Wooohaaa/anlogic-vision-system/docs/操作与部署.md

# 操作与部署

KEY1切换图像模式，KEY2开关双步进跟踪，KEY3开关白平衡，KEY4开关自动曝光与亮度增益。SW1控制颜色形状与运动，SW2控制ArUco，SW3控制手势，SW4控制数字识别。

板上采用联合Flash启动，电机默认关闭。电机使用独立12 V供电，并与开发板共信号地；控制接口为3.3 V。详细排针定义见技术文档。

工程构建与烧录使用仓库根目录tools/repository.py，安装路径通过config.local.json或环境变量配置。firmware目录保存FPGA配置、MCU应用和联合镜像，PACKAGE_MANIFEST.json提供SHA256校验。

## 2026-10-31 联合 Flash 记录

R6 areaopt4 FPGA bitstream 与 MCU target-os r18 payload 已组合为仓库 firmware/camera_system_flash.bit，并使用 FutureDynasty 官方命令行写入 PH1P35MDG324 外部 SPI Flash。器件 ID 0xC8，镜像 14,775,152 字节，厂商页写入与校验通过。串口和电机命令均未发送。

MCU 镜像保存在 Flash 中，启动程序负责校验并搬运到 MCU TCM；本次没有进行断电冷启动，因此不据此确认上电自动加载。当前 17 段视频套件未全部通过，已知问题见 [回归记录](VIDEO_SUITE_VALIDATION_20261029.md)。完整哈希和终端日志见 [部署记录](FPGA_MCU_FLASH_DEPLOYMENT_20261031.md)。

仓库 tools/repository.py program 是可选的本地构建流程入口；本次部署证据来自 FutureDynasty 命令行记录，不是该脚本的执行结果。
