Wooohaaa/anlogic-vision-system/THIRD_PARTY_NOTICES.md

# 第三方来源

- FPGA官方RTL、加密IP与工程来自Anlogic板卡工程，位于`contest2_hdmi_video/rtl/official`和`prj/user_source`；保留原文件及声明。
- `vendor/anlogic_sdk`来自当前工程实际使用的PH1P35 SDK，保留其各文件原许可声明。不同子组件可能采用不同许可证，不以本项目名义改写。
- TD、FD、GNU工具链可执行程序、USB驱动、调试服务均未打包，需要自行安装。
- 未给整个目录擅自添加MIT等统一授权；公开仓库前按原厂/第三方条款确认加密IP及SDK的再分发范围。确认之前可先使用私有仓库。
