Wooohaaa/anlogic-vision-system/docs/赛题二技术文档_实时图像处理与视觉交互系统.docx

# 基于安路FPGA的实时图像处理与视觉交互系统

摘要

本作品面向选题二实时图像处理任务[1]，基于安路PH1P35 FPGA构建720p视频处理平台。SC500摄像头经MIPI输入，图像由FPGA处理后写入DDR并通过HDMI输出；处理链包含自动白平衡、自动曝光、暗部增强、降噪和七种图像模式。FPGA完成颜色与形状、运动区域、手势及数字卡识别，板载MCU处理ArUco标记并调度双轴步进云台。系统采用四像素并行结构，按键切换图像模式和检测功能，画面叠加帧率、链路延迟及识别结果。

第一部分 作品概述

  1.1 功能与特性

系统以1280×720、60 fps视频为输入，通过HDMI输出。KEY1切换直通、灰度、Sobel、二值化、素描、浮雕与卡通化；KEY2控制步进跟踪，KEY3控制自动白平衡，KEY4控制自动曝光和增益。拨码开关分别启用颜色形状、运动、ArUco、手势与数字识别。识别框、类别和坐标叠加到画面，数码管显示增益index和开关状态。

  1.2 应用领域

系统用于实时图像处理教学与视觉交互演示。风格化模式显示像素处理结果；颜色目标联动云台演示视觉跟踪；数字卡和手势作为交互输入；ArUco标记叠加ID和方向轴，展示标记检测与图像可视化。

  1.3 主要技术特点

视频主链采用96位、每拍四像素的并行结构，像素、有效标志、行末和帧首信息同步传递。灰度、边缘和检测旁路共享数据流与行缓存，帧级统计和模板匹配复用运算单元。MCU处理ArUco候选解码和控制调度，FPGA负责固定吞吐的视频处理和步进脉冲时序。

  1.4 主要性能指标

资源数据采用最终整机布局布线结果，MCU数据来自最终应用构建记录；目标器件为PH1P35MDG324。联合镜像通过FutureDynasty官方命令行写入SPI Flash并完成逐页校验，指标见表1。

表1 主要性能指标

指标 | 数值
视频模式 | 1280×720，60 fps
彩色接口 | 96位，每拍4像素
Slice | 20,091 / 21,216
ERAM | 103 / 108
DSP | 30 / 40
建立裕量 SWNS | +0.132 ns
保持裕量 HWNS | +0.020 ns
总负裕量 | STNS / HTNS 均为0
联合镜像 | FPGA配置与MCU应用

  1.5 主要创新点

（1）构建采集、识别、显示与双轴执行闭环，实现视觉结果直接驱动机电联动。

（2）设计FPGA与片内MCU协同架构，兼顾并行视频吞吐、标记解码和控制调度。

（3）以四像素并行流水线、共享缓存和运算复用，在单芯片集成多模式处理与多类识别。

（4）将帧首时间戳与DDR帧槽绑定，在线观测对应视频帧的链路延迟及有效输入输出帧率。

  1.6 设计流程

以720p实时视频与视觉闭环为目标，先完成MIPI接收、DDR帧缓存和HDMI输出，统一四像素数据通路及帧级接口；随后集成画质增强、七种图像模式与多类识别，建立FPGA与MCU任务分工；再接入双轴步进云台，实现识别坐标到执行动作的联动。通过实机光照变化、目标切换及两轴动作逐项验证功能，结合布局布线报告优化资源及时序，最终生成并部署FPGA与MCU联合镜像。

第二部分 系统组成及功能说明

  1.1 整体介绍

系统由SC500摄像头、PH1P35开发板、HDMI显示设备和双轴步进云台组成。摄像头RAW10经MIPI输入FPGA；处理后的视频写入DDR并输出至HDMI。内容分析模块读取彩色视频，ArUco灰度快照送往MCU，识别结果返回FPGA叠加显示。红色目标坐标进入控制流程，MCU计算运动请求，FPGA输出STEP、DIR、SLP和RST信号。

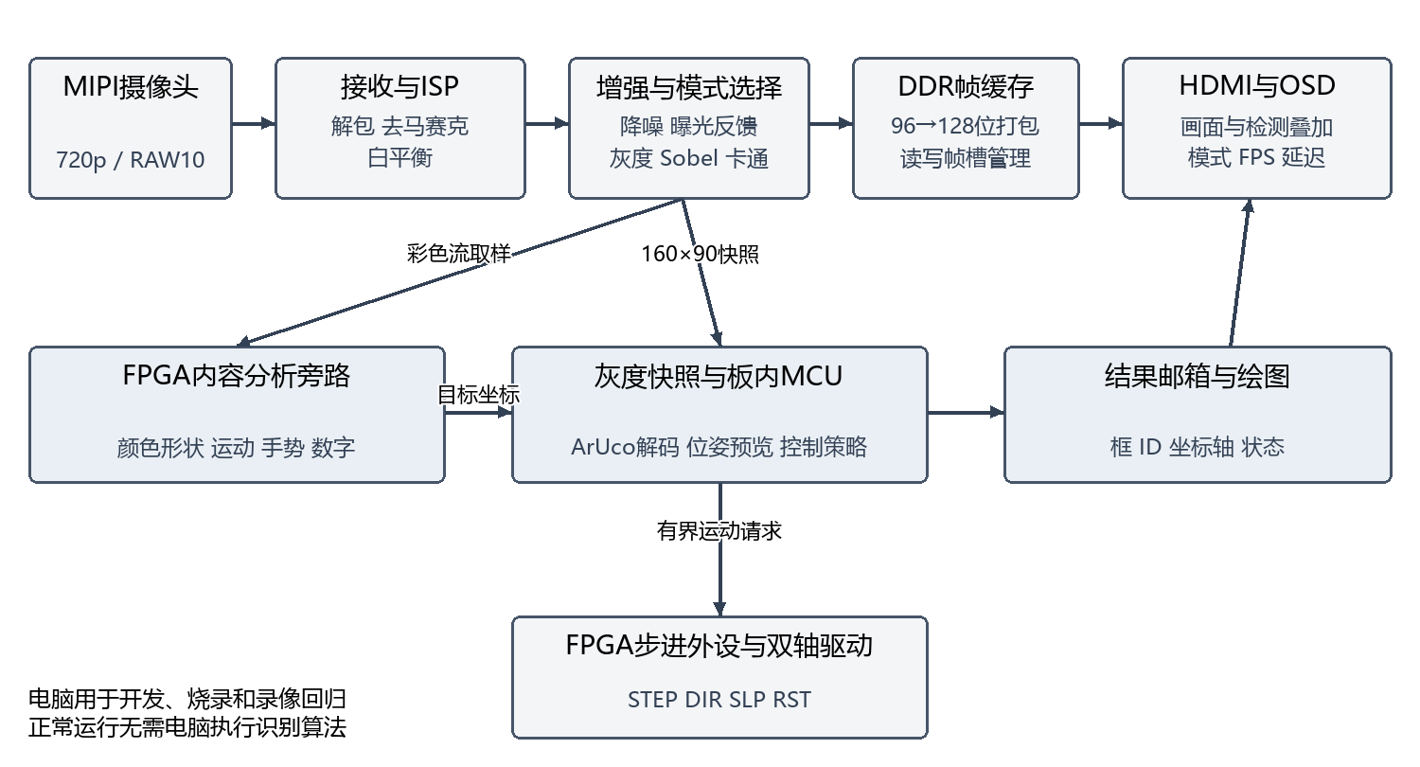
[picture p1: figure]

图1 系统数据通路与控制关系

  1.2 硬件系统介绍

2.2.1 硬件整体介绍

核心器件为PH1P35MDG324，使用板载DDR、SPI Flash、时钟、按键、拨码开关和数码管。SC500系列MIPI摄像头配置为1280×720模式；HDMI连接显示器或USB采集卡。系统时钟包括CSI恢复时钟、DDR时钟、HDMI像素时钟和50 MHz系统时钟，各时钟域通过帧缓存、邮箱、同步器和握手交换数据。

2.2.2 机械设计介绍

执行机构为双轴旋转云台，摄像头随云台转动。系统根据画面中心与红色目标中心的偏差，分别控制水平轴和俯仰轴。软件置零定义启动参考位置，累计步数用于相对运动控制；两轴方向经实物动作确认。

2.2.3 电路各模块介绍

摄像头连接开发板原有MIPI及I²C接口，HDMI使用板载输出，AL-LINK-FT用于工程下载。步进驱动采用DCC-100v3，J2扩展排针分别连接两路STEP、DIR、SLP和RST。GPIO控制电平为3.3 V，驱动由独立12 V电源供电，FPGA与驱动共信号地。

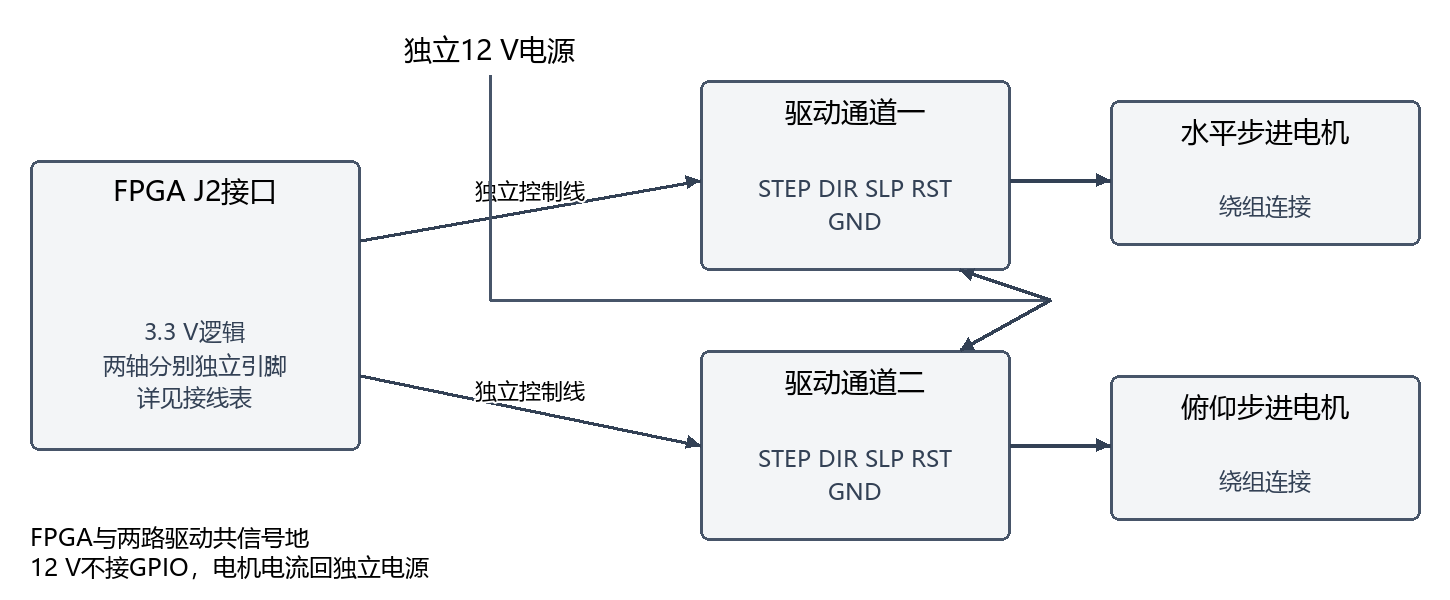
[picture p2: figure]

图2 步进驱动供电与控制信号

J2引脚与驱动信号对应关系见表2。

表2 J2引脚与驱动信号

开发板J2 | FPGA球脚 | 外部驱动连接
3 | E12 | 第一路 STEP
4 | E16 | 第一路 DIR
5 | E17 | 第一路 SLP
6 | F13 | 第二路 STEP
7 | F14 | 第二路 DIR
8 | F18 | 第二路 SLP
9 | G17 | 第一路 RST
10 | H17 | 第二路 RST
12 | GND | 第一路信号地
28 | GND | 第二路信号地

  1.3 软件系统介绍

2.3.1 软件整体介绍

软件由FPGA维护RTL、板载MCU程序和电脑端开发工具组成。RTL处理固定时序的视频数据，MCU运行视觉任务与控制调度；电脑端工具用于工程配置、构建、制作联合镜像和官方命令行下载。识别与控制任务在板上运行，电脑采集卡用于观察和录制HDMI画面。

2.3.2 软件各模块介绍

内容分析流程从彩色视频旁路取样，按帧发布检测结果；ArUco流程将灰度快照交给MCU解码，绘图数据返回FPGA后叠加到HDMI画面。

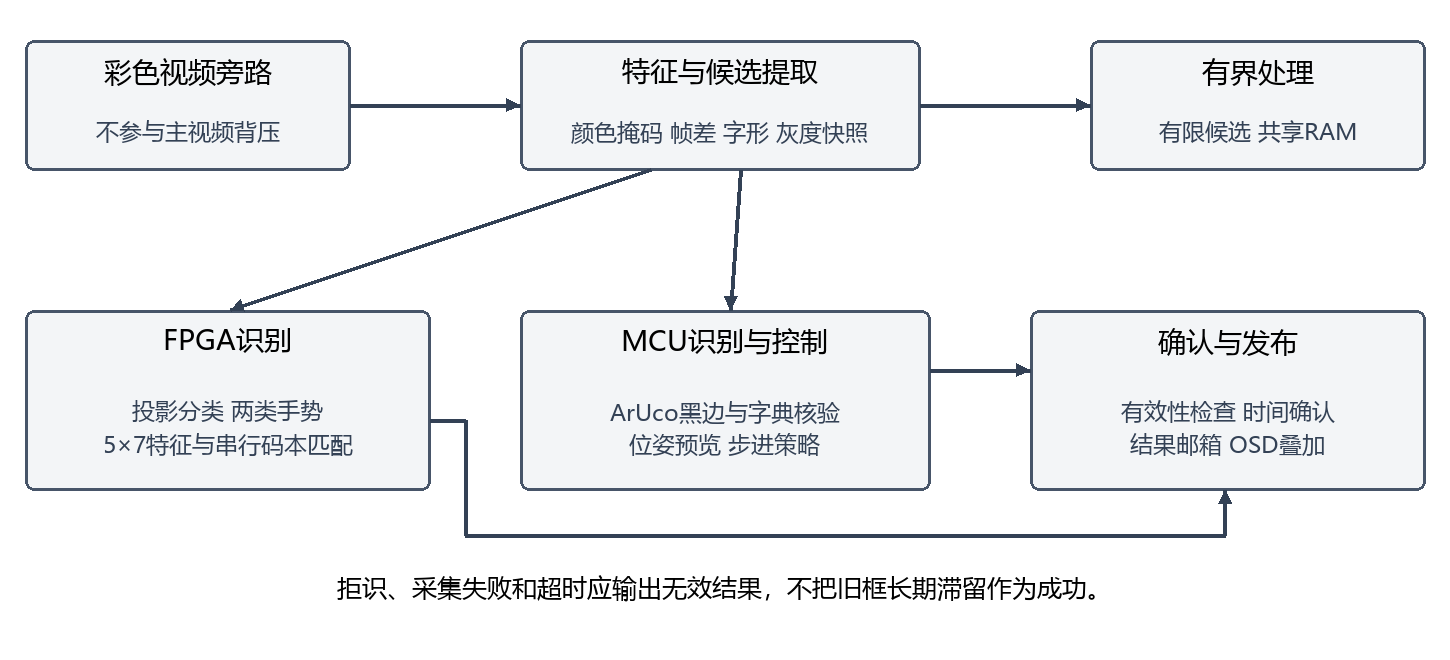
[picture p3: figure]

图3 内容分析与结果发布流程

视频采集与四像素流水线

SC500摄像头经MIPI接口输入RAW10数据，接收端完成数据解包、黑电平处理与Bayer去马赛克，将其整理为RGB888像素。视频计算采用96位总线，每个有效时钟同时传递四个连续像素。1280像素的一行对应320个数据组；主链在保持720p画面尺寸的同时，以并行计算降低单路处理节拍压力。

流水线将像素数据与tvalid、tuser、tlast一同传递，分别标记有效数据、帧起始和行结束。行缓存只在有效样本到达时更新，数据和边带信号则按约定的级数延迟；遇到有效信号空拍时，缓存地址和窗口位置仍与真实像素对应。模式选择经按键消抖和跨时钟域同步后在帧首锁存，使同一帧采用统一的处理方式。

处理后的视频经宽度适配进入DDR写通道，HDMI读通道按显示时序读取完整帧。DDR帧槽承担采集和显示之间的速率匹配，算法行缓存承担邻域访问，两者各司其职。颜色、形状、手势、数字与ArUco前端从风格化之前的彩色视频取样，识别所用的颜色和亮度不会随显示模式切换而改变。

七种图像模式的计算过程

直通模式保持RGB分量；灰度模式对每个像素计算红、绿、蓝分量的加权和，绿色权重为红、蓝的两倍，再右移两位完成归一化。该形式由加法和连线移位实现，不需要通用乘法器。二值化模式将组均值亮度与阈值比较，输出黑或白，适合直接观察明暗分布与分割边界。

Sobel模式先对同拍四个灰度值求均值，再在组灰度域建立3×3邻域。两个历史行缓存与当前行移位寄存器提供窗口，横向和纵向梯度分别按Sobel系数累加，取绝对值后求和并缩放为边缘强度。同一组的结果扩展到四个输出像素。因此，彩色主链仍是1280×720，邻域边缘计算则采用320组宽度的流式结构，显著减少行缓存和重复梯度运算。

素描模式将边缘强度反相，形成白底黑线；浮雕模式对窗口中的对角位置作方向差分，并加入中灰偏置，将正负变化转换为明暗层次。卡通模式在彩色支路进行亮度分段量化和受控饱和度增强，再以Sobel结果绘制轮廓。七种模式共用灰度、窗口和边缘结果，彩色支路按拍延迟对齐；模式选择位于统一输出端，用户算法模块保持固定八拍延迟。

自动白平衡与曝光控制

自动白平衡采用受约束的灰度世界统计。模块排除裁剪高光、过暗像素和高色度区域，从中等亮度、接近中性色的有效样本中累计红、绿、蓝分量；同时检查画面不同区域的样本支持和估计一致性，避免单一有色物体主导全帧增益。可信统计形成后，以绿色为参考计算红、蓝两路校正系数，限制系数范围，并通过连续估计确认和低通平滑抑制逐帧抖动。

增益估计与逐像素校正分开运行：统计在帧内持续累积，除法计算在帧级状态机中执行，候选增益只在后续帧首提交。这样，当前帧不会出现上半幅和下半幅采用不同增益的色彩分界。关闭白平衡时，控制逻辑按既定旁路配置运行，像素和边带仍保持统一时序。

自动曝光模块读取帧级亮度统计，综合主体亮度与高光情况决定曝光时间和模拟增益。偏暗时逐步增加曝光或增益，偏亮时反向调节；确认帧和稳定等待帧控制更新频率，避免每次亮度波动立即引发反向动作。统计结果通过稳定数据总线和翻转握手跨入控制时钟域，再由I²C配置流程写入SC500寄存器。KEY3、KEY4分别控制白平衡和曝光增益，数码管显示增益index，便于观察闭环调节过程。

降噪与暗部层次增强

图像后处理采用带色差门限的可分离有限窗口滤波。水平和垂直方向分别利用五个原始样本，按1、2、2、2、1的权重组合；只有邻域与中心的三个颜色分量差异均满足条件时，邻域才参与平滑。强边缘处保留中心值，平坦区则利用邻域平均降低噪点，避免简单全局平滑把目标轮廓一并抹去。暗部采用相应的色差门限，使低亮度区域获得更有针对性的处理。

后续色调与暗部提升由固定曲线和受控饱和度处理完成，曝光增益仍承担主要的亮度调节任务。有限窗口保存输入历史，不以已滤波输出递归累积；历史行数据打包到同步RAM中，以一拍读出、后续写回的方式形成垂直窗口。该模块保持每拍四像素的连续输入输出，以六级流水完成降噪和色调处理，逐像素路径不使用整帧平均、迭代除法或DSP乘法。

颜色分割与旋转形状判别

颜色检测在四像素组上统计RGB均值，以主色通道相对另外两路的差异、亮度和色度形成红、绿、蓝掩码。门限同时考虑暗部与颜色饱和情况，结合肤色排除和局部连续性，减少手持目标时手部与目标颜色相互干扰。每种颜色保留候选区域，随扫描更新面积、包围范围和投影极值，再按支持量与连续性选出用于发布的目标。

形状判别使用面积、宽高比、填充率与多个方向的投影跨度。除水平和垂直范围外，还统计斜向投影，比较归一化包围面积以选择更贴合目标朝向的几何尺度。长宽比反映细长程度，面积与包围面积的比例反映轮廓填充特征；这些信息共同支持圆形、方形、长条形与三角形判别。比例门限以交叉相乘比较，方向归一化使用已知的比例系数，避免在线开方和通用除法。

帧内只更新候选统计，帧末才启动形状计算、坐标平滑及类别确认，最终一次性发布中心、边框和类别。短时缺失、类别切换和重新捕获由独立的时间状态处理，使单帧颜色波动不会直接替换画面上的稳定结果。识别输出同时送往OSD和目标跟踪接口，显示与控制使用同一份帧级位置结果。

运动检测与相机运动抑制

运动模块在四像素组均值灰度域比较当前样本与上一帧同位置的参考值。参考存储通过同步双端口访问，当前地址读取旧值，地址和新灰度延后一拍写回，完成连续流中的读旧、比较和更新。整机配置对参考图作纵向间隔采样；显示视频仍逐拍完整传递。首帧先建立参考，背景重建请求锁存后在下一帧边界统一执行。

变化样本进一步累计到32×32网格。只有获得足够变化支持的网格参与运动范围统计，帧末汇总形成黄色区域框，并由MOV给出运动网格比例。云台动作信号送入网格策略：相机转动期间停止发布场景运动提示，停止动作后等待安静帧再恢复，从而把机械转动造成的整幅背景变化与被摄物运动区分开。

手势识别的帧级处理

手势支路将彩色样本转换为低分辨率手部观察帧，分别构造可靠种子和扩展候选掩码。连通域阶段按扫描顺序关联相邻区域，记录面积、包围范围、实际锚点和红色分量支持；随后在种子与扩展区域之间建立关联，用较宽的扩展轮廓保留手掌结构，用种子的颜色可信度约束背景混入。

候选先经过尺寸、比例、面积和颜色均值等低成本筛选，再进入选中区域的几何分析。区域掩码、掌心距离、轮廓、凸包与指尖相关特征由帧级状态机依次处理，结合投影和形态特征区分张掌与握拳。最终分类还要经过候选质量策略和时间投票，使输出类别、目标框和有效标志在同一观察结果上对应。

采集与分类通过缓冲区所有权握手衔接，分析过程持有的帧不会被下一帧输入覆盖。处理忙时采用明确的接收与丢弃规则，结果在完成后统一发布；连续无有效手部观察时释放历史结果。HDMI中H:O表示张掌，H:F表示握拳，H:-表示当前没有确认结果，诊断字符T反映检测内部状态。

数字卡定位与字形模板匹配

数字识别由定位和分类两级组成。定位器搜索浅色中性背景上的深色笔画，利用亮背景支持、局部行列连续性和字形聚合得到候选范围。确认后的包围框与后续归一化过程保持帧级对应，避免上一帧的框与当前帧笔画混用。卡片发生位置和尺寸变化时，定位状态先更新候选，再按确认策略切换有效区域。

字形以5×7共35个占用单元表示。归一化依据实际字宽划分五列、依据实际字高划分七行，累计各单元内的笔画支持后生成35位特征。尺寸相关的占用门槛使小字形仍能形成有效单元；闭环字形还检查中间行等结构支持，避免局部破碎的笔画仅靠少量相似单元形成高分匹配。

模板库为0～9每类保存64个尺寸、宽高和倾角变体，共640个有效模板。同步ROM逐项读出35位模板，与观察特征异或后计算汉明距离；串行扫描得到每类的最佳距离，再比较最佳类别和次佳类别。结果需同时满足匹配距离、类间差值和时间确认条件。画面左侧数字为识别类别，右侧两位十六进制数为次佳距离减最佳距离，反映类别分离程度；没有确认结果时显示横线。

ArUco识别与方向轴叠加

ArUco采用FPGA前端与片内MCU分工。FPGA将彩色视频取样为160×90灰度快照，通过寄存器和握手机制交给MCU；MCU把灰度压缩为每像素4位，两像素共用一个字节。该图仅服务标记分析，HDMI主图保持原视频尺寸。快照在处理期间保持稳定，MCU完成一轮任务后再释放采集资源。

检测端先建立16级灰度直方图并计算Otsu阈值，提取暗色连通区域与候选四边形，再检查边界支持和几何关系。对有效候选进行透视映射采样，依次验证外圈黑边和内部4×4编码，尝试旋转方向后与50个字典码字比较；局部阈值重试与角点细化用于适应成像变化，唯一字典匹配约束结果发布[2][3][4]。

识别后将四个角点映射回主画面坐标，并以120 mm标记边长和相机模型建立平面投影关系。位姿与方向轴计算在MCU中完成，输出ID、四边形角点及红、绿、蓝轴的二维端点[5][7][11]。FPGA接收完整结果后更新叠加参数，在HDMI上绘制标记轮廓、ID和方向轴，使解码计算与逐像素绘图保持分工。

双轴步进跟踪与硬件执行

跟踪以红色目标中心相对画面中心的水平、垂直偏差为输入。MCU根据使能状态、目标有效性和偏差计算两轴运动请求，并结合中心附近的低速控制、速度上限及加减速调节，使云台在接近目标时逐步减小动作。软件置零定义启动参考位置，累计步数保存相对位移，两轴方向按实物安装关系配置。

FPGA负责具有固定时序要求的STEP脉冲、DIR方向与SLP、RST控制，运动请求通过片内总线寄存器交接。控制状态、动作计数与目标位置分别保存，MCU服务ArUco任务期间，已提交的硬件脉冲仍按设定节拍执行。KEY2管理跟踪使能，视觉结果、运动调度和脉冲执行共同形成从目标位置到摄像头朝向调整的闭环。

信息叠加与板上交互

HDMI混合器在输出坐标域绘制Logo、文字、包围框、标记线段与方向轴。固定内容从同步ROM读取，几何图元依据当前扫描坐标判断是否命中；显示参数按完整检测结果更新，图元与背景视频通过流水级对齐。KEY1切换七种模式，SW1至SW4分别控制颜色形状运动、ArUco、手势与数字功能，便于逐项演示并观察组合运行。

MODE显示图像模式编号，D显示以毫秒计的板内帧链路延迟。延迟测量将输入帧首时间戳绑定到对应DDR帧槽，在该帧进入HDMI输出时取差，避免把不同帧的时间标记直接相减。IN统计每秒完整写入DDR的帧数，OUT统计有效输出的新帧数，重复帧与异常帧不作为有效新帧计入；两项共同反映采集与显示的有效视频吞吐。

2.3.3 资源优化设计

资源优化贯穿本工程的功能扩展过程。设计首先按像素、行、帧和候选任务区分运算频率：连续视频路径保留必要的并行度，帧级任务利用帧间计算时间执行串行状态机；存储按实际访问范围和数据存活期配置。优化对象包括运算器、RAM深度、记录组织、选择网络、常数算术和显示ROM，而不是只调整综合工具参数。

每项结构调整都同时检查数值范围、同步读延迟、同地址读写关系、帧边界和结果发布时间。模块面积用于定位收益来源，最终取舍依据整机布局与布线结果，兼顾Slice、ERAM、DSP和时序。这样可以将节省出的片上资源持续用于数字、手势、ArUco及云台功能的集成。

逐帧更新的AWB运算复用

早期实际启用的AWB链路使用两套50级流水除法器，分别处理红、蓝增益比值；实际增益只需按帧更新。改进后将两个比值任务送入同一个恢复余数迭代除法器，先计算绿色与红色累计值之比，再计算绿色与蓝色累计值之比。一次除法48步，两次共96个计算周期，加上启动和判定即可完成一帧的系数估计，不需要为每个有效像素提供新的商。

增益限幅、稳定性判断和平滑提交保留在帧级控制中，原有视频延迟缓存和数据节拍继续保持。720p配置中每个四像素组最多贡献一个统计样本，单帧最多230,400个样本，8位通道累加的最大值为58,752,000，26位即可覆盖。依此收缩累加器、比较器和状态选择网络，同时保持帧内增益一致。

按实际访问深度重构行缓存与参考帧

AWB原始延迟RAM固定为96位×2048字，720p四像素结构每行实际仅访问320字。工程改为96位×512字的双端口同步存储，逻辑容量由196,608位降为49,152位，减少75%，同时保持原有端口契约和一拍同步读行为。容量压缩来自去除未被访问的地址空间，视频数据宽度和处理精度保持不变。

运动参考图在组灰度域保存8位亮度，整机配置每四行取样一次；参考深度按有效组数和采样行数精确计算，避免宏单元固定深度产生额外占用。图像后处理将四条历史行组织成一个宽字，在读出后移位并写回，减少独立RAM存储体及外围地址控制。主显示帧继续存入DDR，片内ERAM集中服务行邻域和识别状态。

候选描述符与手势工作区复用

颜色与形状检测需要长期保存候选的面积、包围范围和多方向投影。早期使用宽寄存器数组，动态选择候选时会形成较大的多路选择与更新网络。工程将适合串行访问的描述符搬入同步ERAM，帧内按地址读取候选、计算更新结果并写回；保留必要的当前行状态与获胜候选缓存，使连续像素输入不必等待整个候选库访问。

手势链路按处理阶段复用同一工作区：区域扩展队列、掌心距离和轮廓几何等任务在各自拥有存储期间访问地址，前一任务最后一次读取完成后才交给下一任务。公共工作RAM采用同步读和显式读写使能，算法负责初始化所需内容，避免整块存储的异步清零被映射为大量触发器。

连通域关联与描述符构建直接利用已有的组件记录，不再复制一份整帧描述符RAM。对不同阶段互斥使用的数据采用打包存储和端口复用；例如二值路径的原始通道缓存与后续队列共享存储生命期，并以相邻字及双端口组织维持读取节拍。因此，公共存储按各阶段的最大工作集配置，无需为生命周期互斥的数组分别保留完整容量。

三色分类与坐标平滑的分时计算

红、绿、蓝三路目标在帧末的分类任务具有相同的数据形式。工程保留三色候选状态和每色两个候选槽，将面积归一化、长宽比例判断、类别比较等运算送入共享数据通路，依次选通颜色和投影方向，完成后再统一发布三路结果。主像素链路继续每拍接收四像素，共享仅作用于帧级结果计算。

目标中心和边框的坐标平滑也使用共享加法、移位及限幅逻辑，状态机遍历需要更新的坐标字段，结果暂存在工作寄存器中。原本每种颜色、每个坐标都复制的组合运算由同一套计算资源承担，减少重复进位链与宽选择网络。在相同功能组合的整机阶段，字库、坐标平滑与面积归一化共享合并后，Slice由20,491降至19,516，减少975，ERAM和DSP数量保持不变。

定点位宽和常数算术优化

坐标、面积、累加和乘积按各自的合法上界确定位宽。加法和差分在运算前显式扩展，乘法保留所需的全宽结果，比较前统一符号与尺度，避免隐式32位整数把小坐标运算展开为宽数据通路。常数倍数以移位加减实现，比例条件通过交叉乘积判断，减少通用乘除运算。

手势几何中的低频乘积采用共享移位累加单元。紧凑实现将乘积寄存器同时用作部分和与移位状态，只额外保存必要宽度的被乘数，在指定迭代次数后给出完整结果，避免并列保存多个超宽中间量。像素级高频计算与帧级低频计算分别选择并行和串行结构，使DSP资源服务真正需要固定吞吐的路径。

图像曲线与显示内容的ROM化

固定色调曲线由组合分支查表转为同步ROM，保持每个输入码值的映射。对小数系数、饱和判断和通道差值的计算进行范围分析后，将可以共享的项提取出来，减少重复宽RGB选择器。一个图像处理优化阶段的整机Slice由20,916降至20,087，减少829；ERAM由69增至75，DSP保持13，体现了利用片上存储替代组合查表逻辑的效果。

Logo使用无损的分段紧凑表示。元数据先给出当前行段的有效范围与索引起点，再读取颜色索引并查询调色板；透明区域由有效性标志直接处理，不必为全部背景地址存储完整RGB值。颜色索引主体采用9位存储，并对需要扩展的索引进行补位，既保留原有彩色点，又降低索引存储宽度。元数据、索引、调色板形成三级同步读取，混合器提前发出地址以维持外部像素时序。

文字字库只保留界面实际使用的英文、数字、标点及“安”“路”字形，整理为1024×16同步ROM。字符码和行号转换为紧凑地址后一次读出字形行；原有字形点阵保持一致。字库、Logo和色调曲线分别按内容特征组织，不再统一依赖大规模组合case展开。

数字模板与特征更新结构优化

数字模板的有效数据为640×35位，按1024×35位同步ROM组织，以统一地址顺序扫描模板。分类器复用一套异或、位计数和最小距离比较逻辑，避免为640个模板同时复制比较树。观察帧只需保存35位占用特征及少量稳定确认状态，模板变体规模不会成比例增加帧级寄存器。

5×7特征按行组织占用状态与写使能，坐标归一化采用明确位宽的边界运算和常数移位加法，缩小可变位索引及动态多路选择结构。特征累积、帧末成图、模板读取和类别发布分属确定阶段，模板同步读所需的等待拍由分类状态机吸收，视频主链不增加反压。

MCU缓存压缩与任务协同

160×90快照包含14,400个灰度像素，8位缓存需14,400字节，4位打包后为7,200字节，图像缓存容量减半。16级直方图与这一表示保持一致，候选检测按阶段复用工作区，解码、角点细化与方向轴计算在同一帧数据上依次推进。软件采用面向体积的编译选项，并保留栈使用记录，使图像缓存、静态数据和函数栈共同纳入片内TCM预算。

最终MCU映像的代码为28,876字节，已初始化数据240字节，静态零初始化区16,572字节；计入2,048字节栈预留后的总预算为47,736字节，满足49,152字节的TCM空间配置。FPGA提供灰度采集、绘图和步进时序，MCU集中处理候选解码及控制调度，避免将复杂的标记几何运算全部复制为FPGA并行硬件。

整机资源收益与最终实现

表3列出开发过程中几项具有整机数据支撑的结构优化。前三项分别对应当时功能组合下的前后对照；最后一项展示最终集成结构与其直接基线的资源分配。不同阶段的功能组合和实现快照不同，各项差值单独计算，不相加作为累计节省量。

表3 代表性阶段资源优化对照

优化结构 | Slice 前→后 | 变化 | ERAM 前→后 | DSP 前→后
图像曲线等查表逻辑同步ROM化 | 20,916→20,087 | −829 | 69→75 | 13→13
字库与三色分类、坐标平滑共享 | 20,491→19,516 | −975 | 97→97 | 25→25
候选存储及算术结构重组 | 19,974→19,708 | −266 | 97→106 | 35→31
最终集成与存储再压缩 | 19,997→20,091 | +94 | 108→103 | 31→30

最终集成在直接基线上增加94个Slice，同时减少5块ERAM和1个DSP，形成20,091 Slice、103 ERAM和30 DSP的整机配置。最终布局布线报告给出的建立、保持裕量分别为+0.132 ns与+0.020 ns，总负裕量均为0。资源优化因此同时服务于功能集成、片上存储分配和时序实现，最终指标统一采用表1所列数据。

2.3.4 联合镜像与部署

联合Flash镜像包含FPGA配置、MCU引导程序和应用载荷。构建入口统一组织RTL、约束、ROM初始化文件与MCU程序，发布时保存最终固件及SHA256校验摘要。联合镜像已通过FutureDynasty官方命令行写入SPI Flash并完成逐页校验，源码、工程配置、最终资源时序报告与技术文档配套归档。

第三部分 完成情况及性能参数

  3.1 整体介绍

本作品完成SC500摄像头MIPI采集、FPGA四像素并行处理、DDR帧缓存、HDMI输出与双轴步进执行的整机集成。在1280×720、60 fps平台上实现七种图像模式、自动画质调节和多类识别，片内MCU完成ArUco解码与云台调度，实机成果见图4至图7。

  3.2 工程成果

3.2.1 机械成果

完成摄像头、双轴步进云台、开发板与驱动器的一体化装配，建立摄像头视轴与水平、俯仰两轴的运动关系。控制流程以目标中心相对画面中心的偏差生成两轴运动请求，结合方向控制与累计步数实现相对位置调节。图4、图5展示整机结构及安装关系，识别坐标与执行机构在同一系统内联动，构成主动视觉跟踪平台。

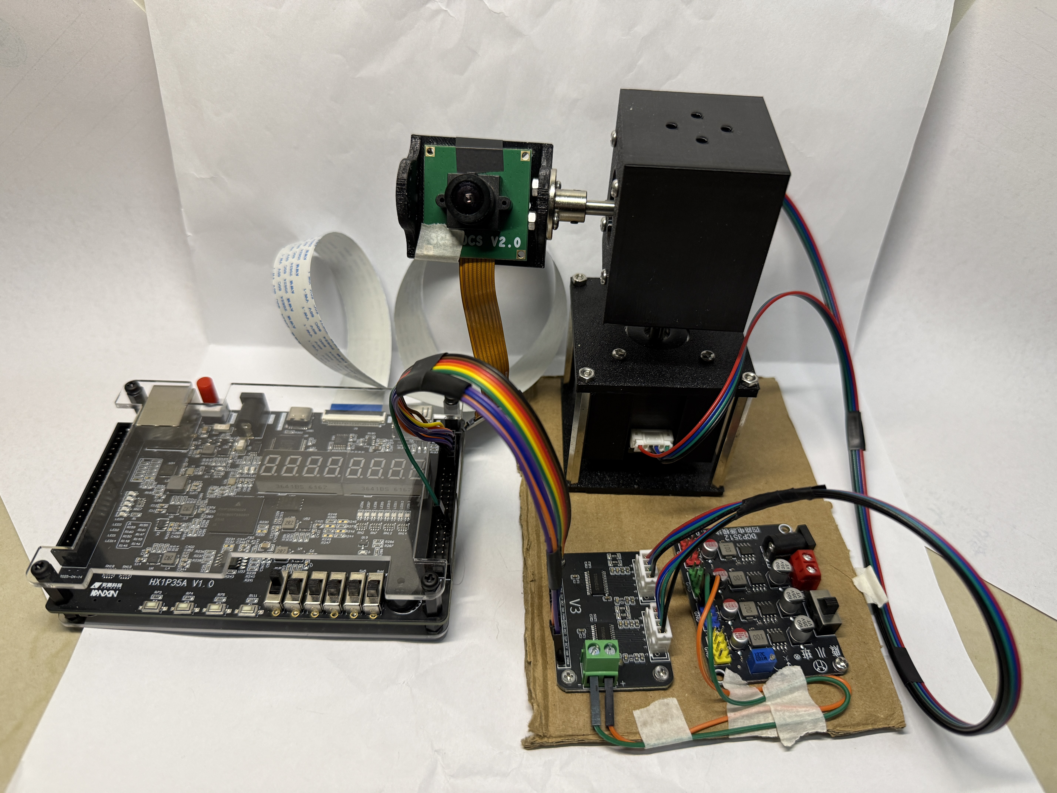
[picture p4: figure]
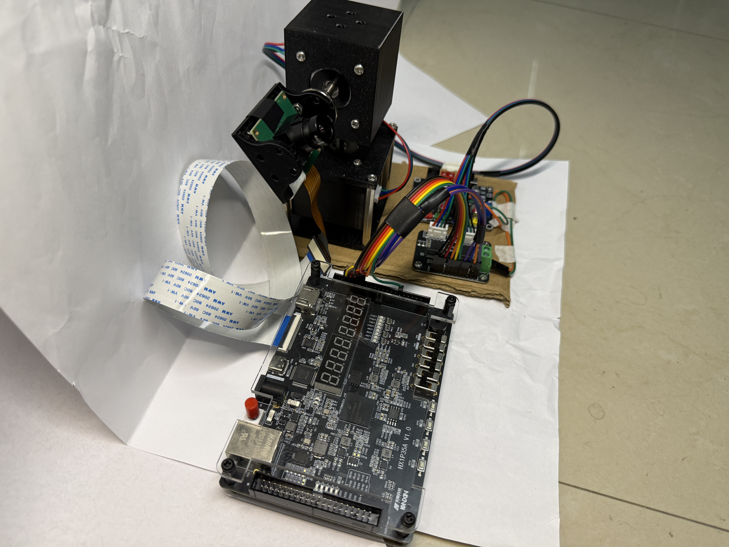
[picture p5: figure]

图4 整机正面 | 图5 整机斜侧面

3.2.2 电路成果

电路成果覆盖MIPI采集、DDR帧缓存、HDMI输出和双轴步进控制。J2引出两轴STEP、DIR、SLP、RST及信号地，驱动器采用独立12 V电源和3.3 V逻辑控制；图2和表2给出供电结构与引脚分配，可与实物接线逐项对应。

3.2.3 软件成果

软件成果包括FPGA RTL、片内MCU应用、TD工程、约束、ROM资源及构建部署工具。图6、图7给出七种图像模式与多类识别的实机结果；FPGA与MCU联合镜像已完成SPI Flash写入及逐页校验。

图6 七种图像处理模式

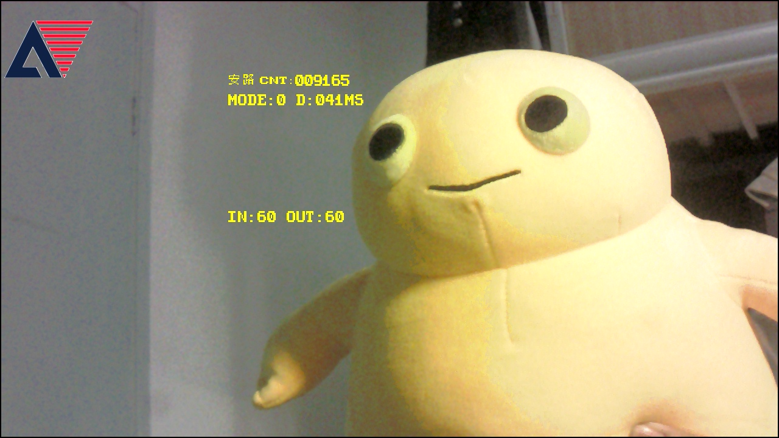
[picture p6: figure]
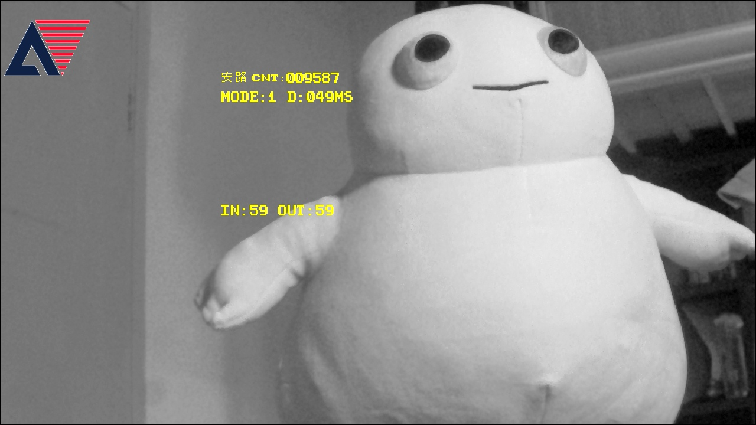
[picture p7: figure]

直通 MODE 0 | 灰度 MODE 1

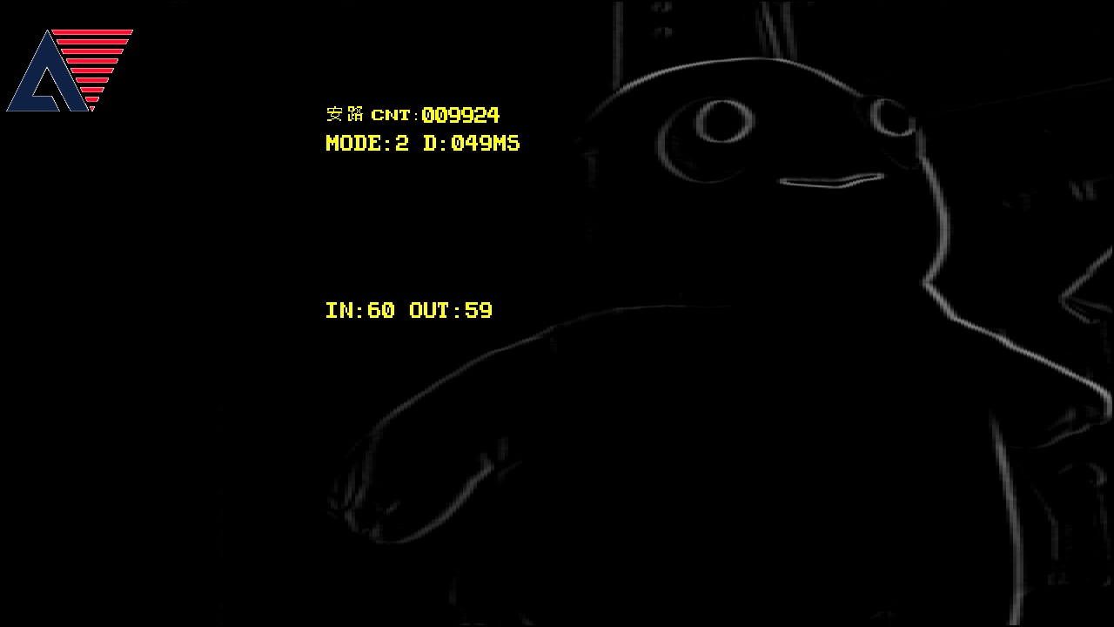
[picture p8: figure]
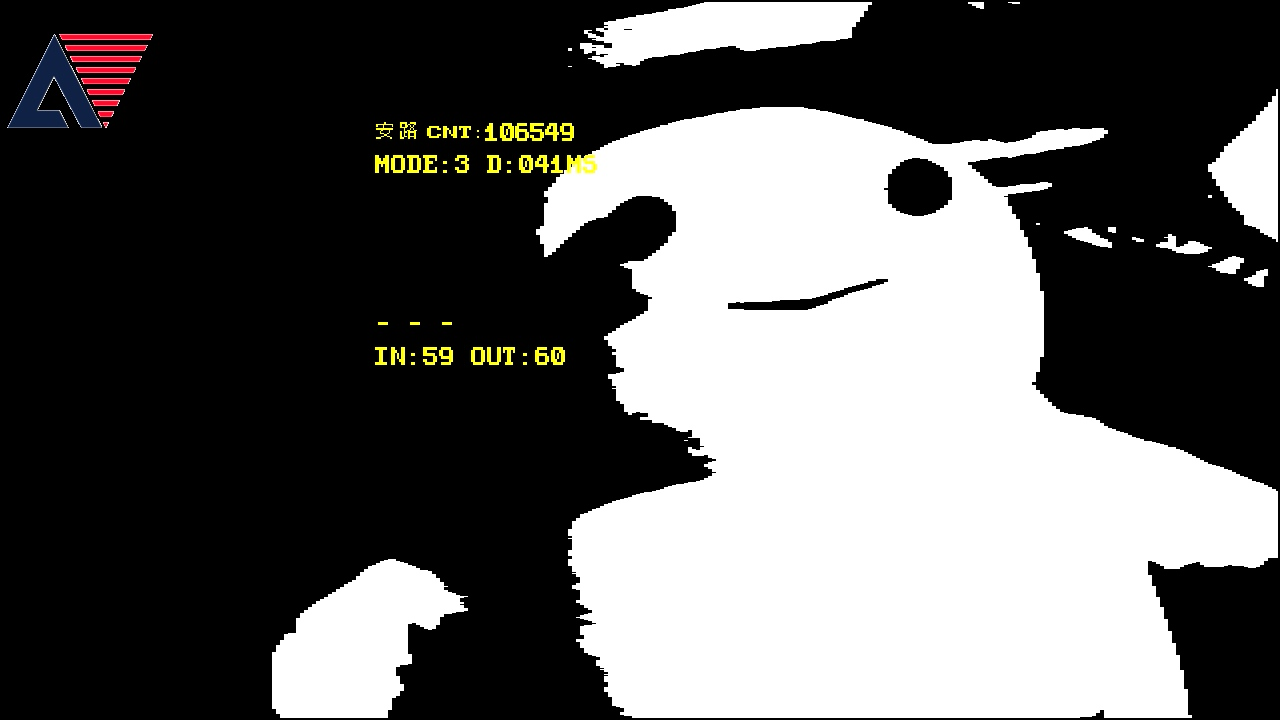
[picture p9: figure]

Sobel MODE 2 | 二值化 MODE 3

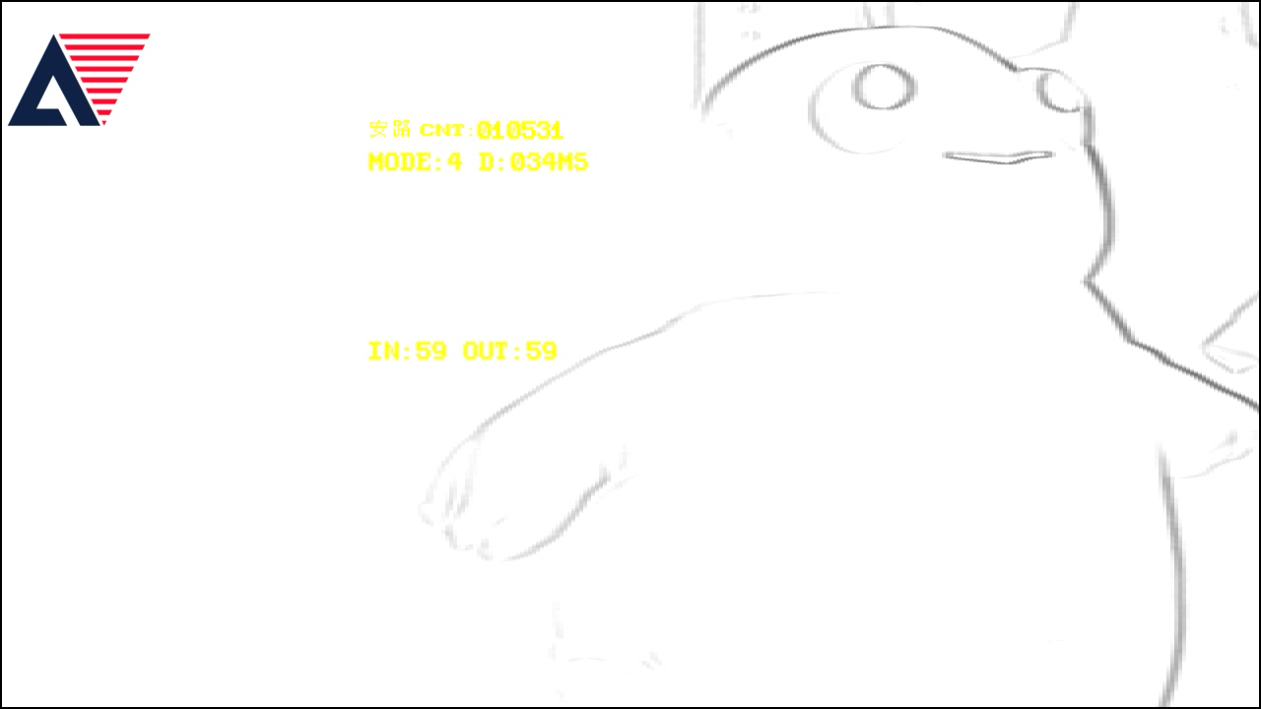
[picture p10: figure]
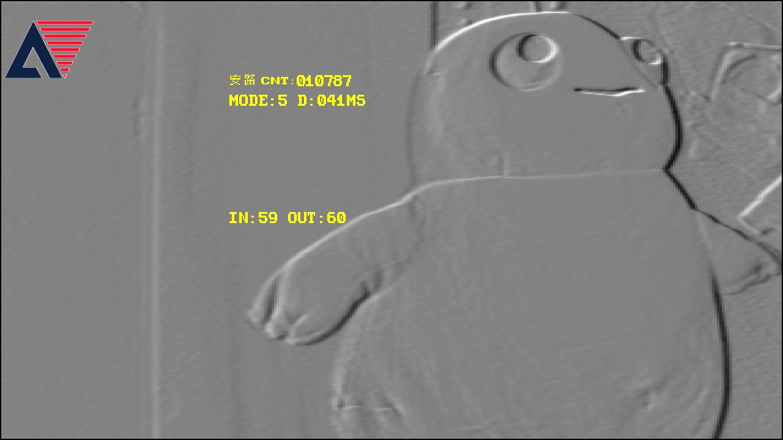
[picture p11: figure]

素描 MODE 4 | 浮雕 MODE 5

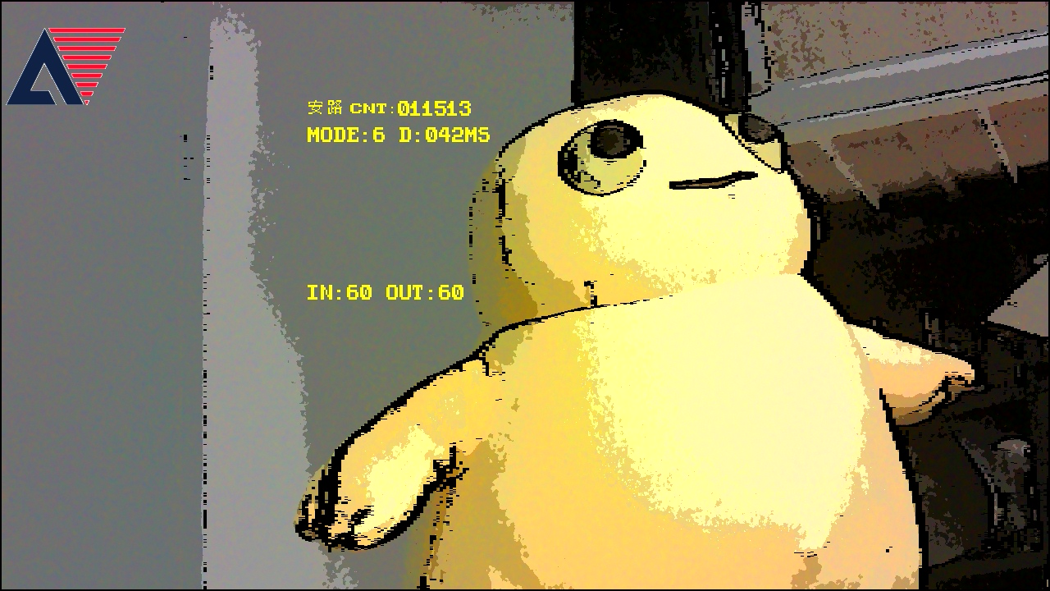
[picture p12: figure]

卡通化 MODE 6

图7 实机识别结果

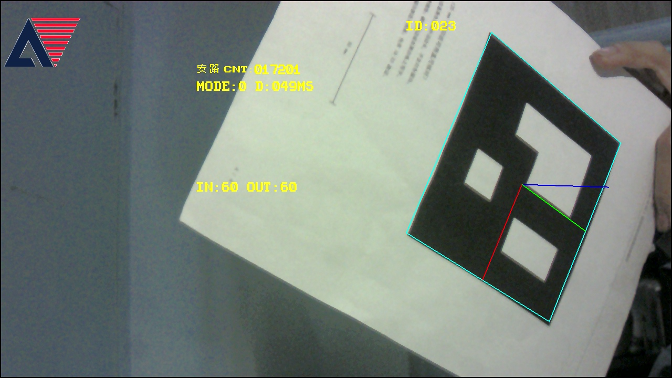
[picture p13: figure]
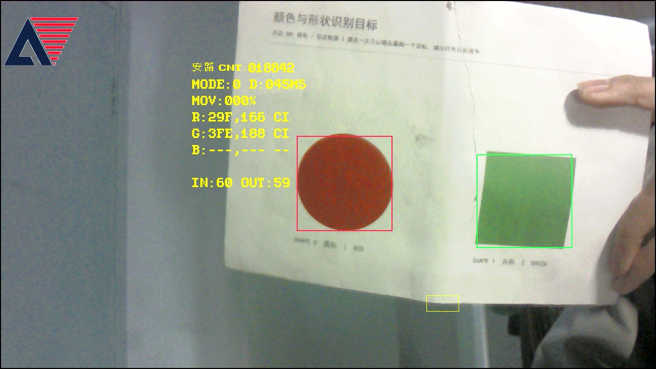
[picture p14: figure]

ArUco ID 23 与方向轴 | 红色圆形与绿色方形目标检测

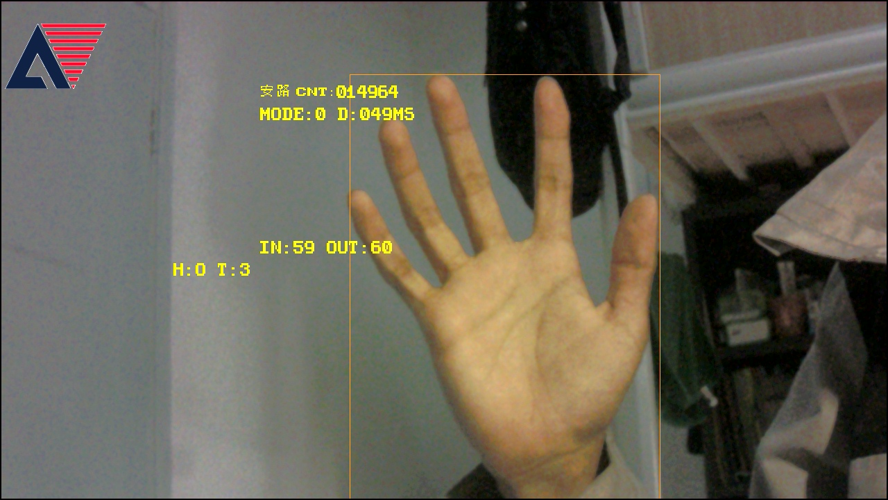
[picture p15: figure]
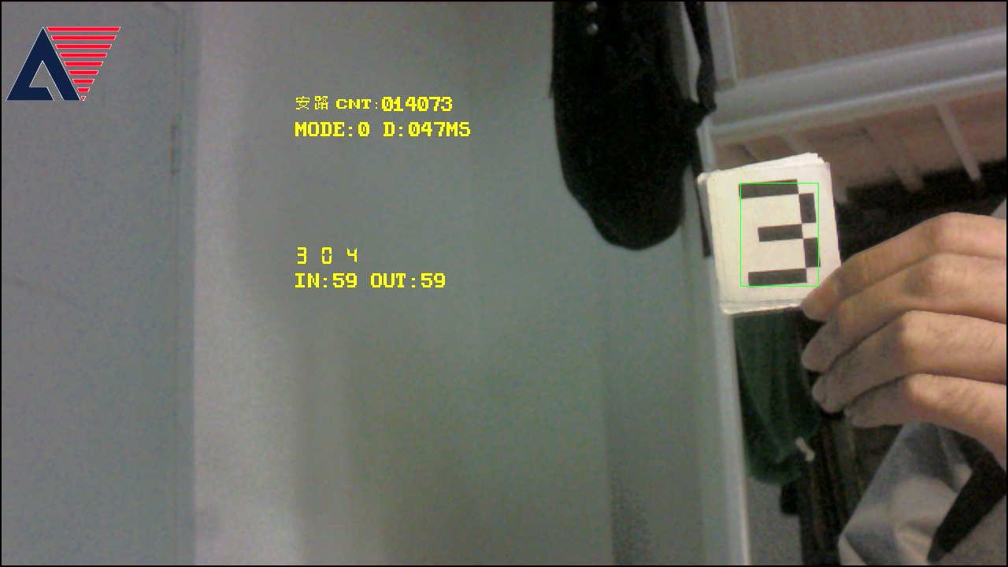
[picture p16: figure]

张掌识别 H:O | 数字卡 3

  3.3 特性成果

最终整机布局布线结果为20,091 Slice、103 ERAM和30 DSP，占器件资源的94.70%、95.37%和75.00%。Routed建立时间裕量SWNS为+0.132 ns，保持时间裕量HWNS为+0.020 ns，STNS与HTNS均为0。资源与时序数据覆盖视频链路、图像算法、识别旁路、OSD、片内MCU及执行接口，体现多功能集成后的整机实现结果。

系统通过帧首时间戳与DDR帧槽对应关系测量板内链路延迟，并在HDMI画面显示对应视频帧的延迟读数；本节实机截图为34至49 ms。IN/OUT按秒统计完整输入与有效新帧输出，结合模式、检测框、类别和坐标标注，实现视频吞吐、处理时延及识别状态的在线观测。表4汇总板上按键操作、光照变化、目标识别与云台动作的实机验证结果，将处理画面、识别信息和执行响应对应呈现。

表4 实机功能验证结果

验证项目 | 实机结果 | 验证方式
视频采集与模式切换 | MIPI采集、HDMI实时输出；七种图像模式按键切换并显示当前状态 | 实机操作与画面记录
自动画质调节 | 改变光照，观察自动白平衡、曝光及增益调节，以及降噪和暗部增强效果 | 实机光照切换
内容识别与信息标注 | 展示颜色形状、运动区域、张掌/握拳、数字卡和ArUco识别及结果叠加 | 实机目标演示
双轴云台跟踪 | 依据红色目标坐标控制水平、俯仰两轴运动，展示目标跟随 | 实机运动演示
OSD与系统部署 | 显示安路Logo、模式、IN/OUT及延迟；联合Flash镜像写入并完成逐页校验 | HDMI实机画面与烧录记录

第四部分 总结

  4.1 可扩展之处

系统将连续像素处理、帧级识别结果与执行控制分层组织，具备面向应用扩展的结构基础。图像支路可接入去雾、局部对比度增强等算法，检测结果接口可承载更多目标类别和标记字典；MCU可在既有邮箱协议上增加任务调度、轨迹规划与外设通信，并接入机械臂、移动底盘等执行机构。结合相机标定、标记地图和多传感器信息，可进一步面向工业定位、机器人主动感知及无人平台跟踪开发专用方案。

  4.2 心得体会

本作品的工程价值在于把图像计算、实时数据通路与机电执行组织成协同运行的系统。设计过程中，我们将吞吐、时序和存储预算作为共同约束，以四像素并行流水线保持视频处理节拍，将行缓存、DDR帧槽和共享存储分别用于邻域计算、整帧传输及识别任务，再通过串行运算和模块复用提高片上资源利用效率。系统性能由数据组织、任务划分和运算结构共同形成。

FPGA与片内MCU的分工贯穿系统设计。FPGA承担具有连续时序要求的像素处理、结果绘制和步进脉冲生成，MCU处理标记解码与运动调度；帧边界发布、邮箱握手和跨时钟域同步将两类任务连接起来。由此，视觉信息能够从像素特征转化为目标坐标，再进入执行控制流程，形成可观测的视觉闭环。

工程验证围绕真实图像输入、板上运算和执行动作展开。我们通过光照切换检查自动画质调节，通过实物卡片与手势检查识别和标注，通过红色目标运动检查双轴跟踪，并在HDMI画面直接观察模式、帧率及链路延迟变化。布局布线报告用于核对整机资源与时序，烧录记录用于确认联合镜像部署。源码、约束、构建配置、联合镜像与校验摘要配套归档，使设计成果能够被追溯、复核和继续开发。这一过程建立了从视频算法到硬件流水线、从板上联调到整机部署的实现方法，为面向具体场景的嵌入式视觉系统开发提供了工程基础。

第五部分 参考文献

[1] 安路科技. 全国大学生嵌入式芯片与系统设计竞赛2026安路赛道选题指南[Z]. 选题二，第16—18页.

[2] GARRIDO-JURADO S, MUÑOZ-SALINAS R, MADRID-CUEVAS F J, et al. Automatic generation and detection of highly reliable fiducial markers under occlusion[J]. Pattern Recognition, 2014, 47(6): 2280-2292. DOI:10.1016/j.patcog.2014.01.005.

[3] OTSU N. A threshold selection method from gray-level histograms[J]. IEEE Transactions on Systems, Man, and Cybernetics, 1979, 9(1): 62-66. DOI:10.1109/TSMC.1979.4310076.

[4] OpenCV. Detection of ArUco Markers[EB/OL]. [2026-10-28]. https://docs.opencv.org/4.x/d5/dae/tutorial_aruco_detection.html.

[5] OpenCV. Perspective-n-Point pose computation[EB/OL]. [2026-10-28]. https://docs.opencv.org/4.x/d5/d1f/calib3d_solvePnP.html.

[6] OpenCV. Image Thresholding[EB/OL]. [2026-10-28]. https://docs.opencv.org/4.x/d7/d4d/tutorial_py_thresholding.html.

[7] HARTLEY R, ZISSERMAN A. Multiple View Geometry in Computer Vision[M]. Cambridge: Cambridge University Press, 2004. https://www.robots.ox.ac.uk/~vgg/hzbook/.

[8] International Telecommunication Union. BT.601: Studio encoding parameters of digital television for standard 4:3 and wide screen 16:9 aspect ratios[S/OL]. 2011[2026-10-28]. https://www.itu.int/rec/R-REC-BT.601/en.

[9] OpenCV. Smoothing Images[EB/OL]. [2026-10-28]. https://docs.opencv.org/4.x/d4/d13/tutorial_py_filtering.html.

[10] OpenCV. Sobel Derivatives[EB/OL]. [2026-10-28]. https://docs.opencv.org/4.x/d2/d2c/tutorial_sobel_derivatives.html.

[11] ZHANG Z. A flexible new technique for camera calibration[J]. IEEE Transactions on Pattern Analysis and Machine Intelligence, 2000, 22(11): 1330-1334. https://www.microsoft.com/en-us/research/publication/a-flexible-new-technique-for-camera-calibration/.
