Wooohaaa/anlogic-vision-system/docs/VIDEO_SUITE_VALIDATION_20261029.md

# 全视频回归工作记录

> 当前状态更新（2026-10-31）：R6 areaopt4 + MCU r18 联合镜像已写入外部 SPI Flash，FutureDynasty 命令行逐页校验通过；本次部署没有回放视频。17 段视频仍未全部通过，当前已知问题为倾斜 3 误识为 2、手机 0 与部分远距离数字漏检、倾斜 ArUco 漏检。冷启动尚未验证。详细部署记录见 [FPGA_MCU_FLASH_DEPLOYMENT_20261031.md](FPGA_MCU_FLASH_DEPLOYMENT_20261031.md)。本文其余轮次记录按发生时间保留，不能替代当前状态。

截至2026-10-29的进展：持续优化已扩展到17段整段原生RTL回放。ArUco的178个参考可见帧已全部检出；数字和形状仍在隔离原型中验证，尚未合入维护RTL，也未完成整机资源及时序闭合。仍未全部通过，仍不烧录。下文早期轮次保留作为历史证据，当前状态以页末记录为准。

下段是2026-10-29当时的操作边界记录，不代表2026-10-31的最新部署状态：用户当时要求仅验证和修复，暂不烧录。此轮未访问JTAG、未启动下载程序，未启电机。此前联合Flash写入中断的状态没有被改变。

## 素材范围

已在C:/Users/Chieh yu/Videos找到截图中的15段录像，另纳入同批ArUco录像和第二段新数字录像，共17段。清单、文件SHA256、分辨率、帧率、帧数及抽帧图位于tmp/video_suite_20261029/manifest.json和contact.jpg。

没有将全部录像标记为通过。数字为原生Icarus RTL回放，ArUco为生产C检测器的主机回放；形状录像尚需建立逐目标标注和RTL回放。主机检测不能证明MCU实时调度和FPGA联合运行性能。

## 首轮结果与修复实验

12段数字录像建立了64个12帧诊断窗口（最终数量以digit/result.json为准）。窗口采用完整1280×720 RGB，不裁切目标，仅遮挡已知Logo区域。原录像仍带旧OSD，且部分窗口包含换卡或两张卡，单个抽帧标签需要核对窗口首尾后才能用于验收；目前不计算全视频准确率。

已目视确认2026-10-28 12-59-47在285帧附近的目标为3，基线却输出2。2026-10-28 14-47-52开头手机清楚显示0，但基线未稳定发布。部分候选包围盒只包含数字下半部，背景衣物也会抢占候选。

试验行间距上限32→64，倾斜3窗口的错误发布由6次降到0、正确发布由1次升到2次，但另一原本正确的3窗口从6次正确变为0次，不能推广。白底中性色差放宽到48仍未修复手机0，并导致既有8窗口掉失。扩大横向笔画合并间距到32也出现新的错误输出。这三个原型均保存在tmp/video_suite_20261029，没有并入维护RTL。

这些结果说明不能靠全局放宽几个阈值解决全部录像，后续需要改善候选之间的独立性、完整笔画归属以及候选质量排序，并保留现有三帧确认、撤除和误检负例约束。

## ArUco全段检查

17段视频均已逐帧解码并送入生产C检测器，采用与FPGA相同的8倍抽样和4bit亮度。视频容器报告帧数与实际可解码尾帧有少量1帧差异，分别记录，没有静默计为成功帧。

标记录像实际解码969帧，生产检测器有662帧输出ID23、无其他ID；OpenCV参考检测到ID23的178帧里，生产检测器有48帧未检出。因此该录像仍存在漏检，不能宣布通过。OpenCV参考本身也不是人工真值，生产检测到而OpenCV未检出的帧不能直接算误检。其余16段未出现ArUco有效输出。

## 验收待办

1. 核对数字窗口的稳定展示、换卡、多卡、遮挡和撤除标签；建立整段时间区间标注。
2. 对数字定位失败窗口进行逐行关联检查，设计候选隔离与质量排序修复，完整重跑新旧正例和负例。
3. 分析ArUco的48个参考可见漏检帧，区分候选、四边形、采样解码和细化失败。
4. 给四段形状录像建立逐目标标注，检查红色皮肤误检、倾斜矩形和检测框跳动。
5. 全部必要回归通过后核验整机资源、最终时序；烧录须等待用户重新要求。

以上为首轮基线状态：当时维护源码仍为前一轮完成布线的实现。新增内容为验证工具、素材清单和失败证据。

## 下一步定向优化结果（2026-10-29，未烧录）

### ArUco：已合入 MCU 维护源码

修改 `../mcu_tracking/aruco_app/aruco_detect.c` 及头文件预算说明，保留 FPGA RTL、像素格式、快照接口、运行时超时和电机控制协议。

- 基线48个参考可见漏检帧中，31帧没有合格四边形，17帧有候选但无法解码。灰度图和几何日志显示，部分阴影标记在全局Otsu阈值下与周边暗背景连通，不能靠角点细化解决。
- 保留原有两个严格解码路径。候选两次解码均失败时，才尝试现有的实测边缘细化后重新采样，依旧要求完整黑边、唯一字典匹配和零位错误。
- 原分割整帧没有结果时，最多再做两遍较暗的分割（每次阈值减1个4bit亮度级）。每遍最多32个被采样核验的候选，复用原visited及队列，不新增持久工作区。溢出仍直接拒绝该帧，不允许把碎片重新解释成标记。
- 重用直方图结束后不再需要的 `index` 记录重试次数。每次 `begin` 清空，不跨帧复用结果；已成功的原路径优先结束。
- 初次目标构建超过原2KiB栈保守预算80字节；检测器文件采用GCC `Os`尺寸优化后通过。未启用fast-math，未降低栈预算。

| 离线指标 | 基线 | 本轮最终维护源码 |
| --- | ---: | ---: |
| 标记录像：969帧中的ID23输出 | 662 | 811 |
| OpenCV参考可见178帧中的漏检 | 48 | 9 |
| 原有有效帧丢失 | — | 0 |
| 标记录像错误ID | 0 | 0 |
| 其余16段的有效ArUco输出 | 0 | 0 |
| 旧1657帧录像中的ID23输出 | 1318 | 1547 |
| 旧录像原有有效帧丢失 | — | 0 |

17段共解码11293帧，每段帧数和基线逐一核对；未将容器尾帧差异当作成功帧。OpenCV仍只作参考，不是人工真值，不计算全视频准确率。

1255组合成回归全部通过：1105个必过正负例和150个小尺寸倾斜例；原字典、采集状态机、运行时超时/关闭/采集错误/不自动启动电机契约通过。新增53帧调度分割测试（原48个漏检帧和5种均匀背景），预算1、7、64、1024得到相同检测结果；零预算不推进、完成后重复调用不改变结果。最大观测读像素数69666次/帧。

固件构建：text29164、data240、bss16564，加2048字节栈保留共48016/49152字节，余1136字节。ELF SHA256 `af50c8a8705b5397dffe71d6af97b3c4a0fafb8fbb2d860f6febf57e6a9b0a05`。编译器仍有原有RWX LOAD段警告。本地ELF、BIN和MAP保存于 `tmp/aruco_targeted_final_20261029/`，仅为离线候选固件，没有联合镜像打包、JTAG、Flash或电机操作。

**实时边界**：有限重试增加总工作量。标记录像64节点服务调用数最大值607→1303；每候选最多972次解码读取、1152次救援细化读取及1152次成功后细化读取。新增整帧重试还会清空1800字节visited位图。53帧调度测试只能证明结果不依赖预算分割，不能证明50MHz MCU服务时延、帧率或2KiB栈实际最坏水位；这些需要后续板上测量。FPGA RTL未改，因此本轮没有重新综合、布线或声明新时序通过。

剩余9个参考可见漏检源帧（零基）：138、139、140、318、344、752、762、933、935，属于 `2026-10-27 10-33-03.mp4`。几何跟踪仍显示角点缩入、短边细化不成立或标记连通域被背景污染；没有用放宽码字或黑边约束来掩盖残留问题。

### 数字：完成64窗口试验，原型拒绝合入

新原型按已闭合的笔画运行维护6个独立候选，避免每行只有一个候选立即打断其他区域；仅保存在 `tmp/video_suite_20261029/targeted/locator_slots.v`，没有替换维护RTL。

倾斜3窗口case24：原来6次错误发布降至0次、正确发布1→2次，但后半段手部靠近时仍得到截断框，白底闭合条件是否为直接原因还需逐行跟踪确认，不能称已稳定修复。手机0的三个窗口case35/36/37：正确发布0/0/0→2/0/6次。回放12帧包含定位、特征中值和三帧确认的启动延迟，以上是事件计数，不是准确率。

完整64窗口重放后发现确认的旧场景退化：case30（稳定手机1）9→7次，case39（稳定手机2）8→4次，case44（稳定手机9）2→0次，故拒绝合入。维护数字定位器、识别器、模板ROM的SHA256均与首轮基线一致。

同时完成64窗口首尾复核及7个窗口全部12帧目视复核（共84帧）。原单标签样本存在换卡/多卡/手机滑屏污染，例如case12由4与5重叠变成5、case28由8与9重叠变成9，不能把这些窗口的所有非旧标签输出都算作新误识。case26首尾实际上是5，原记录为6，完整区间标签尚待补齐。结构化复核见 `docs/VIDEO_SUITE_DIGIT_LABEL_REVIEW_20261029.json`，逐帧拼图见 `tmp/video_suite_20261029/targeted/filmstrip_*.jpg`。没有覆盖原始证据或把首尾复核写成全区间真值。

### 复现与证据

在 `contest2_hdmi_video` 目录运行以下命令，均不烧录：

```powershell
python tools/replay_catalog_aruco_20261029.py --name aruco_targeted_final
python tools/replay_aruco_v95.py --source ../mcu_tracking/aruco_app --name targeted_final_20261029
python tools/test_aruco_v95.py --source ../mcu_tracking/aruco_app --name aruco_targeted_final_20261029
python tools/test_aruco_budget_20261029.py
python tools/build_aruco_v95.py --source ../mcu_tracking/aruco_app --name aruco_targeted_final_20261029
python tools/replay_catalog_digits_20261029.py --name digit_slots_all --locator tmp/video_suite_20261029/targeted/locator_slots.v
python tools/audit_targeted_suite_20261029.py
```

最终核验 `tmp/video_suite_20261029/targeted/final_audit.json` 汇总17段逐帧保留检查、旧录像、合成回归、调度分割、固件空间、源文件和产物哈希。旧源码备份在 `tmp/video_suite_20261029/targeted/production_before/`；本轮工具没有把旧版本号改写成已部署新版本。

仍待完成：数字完整笔画归属与候选质量排序、余下时间区间人工标签、9个ArUco残留漏检、四段形状录像逐目标回放，以及获准恢复硬件阶段后的MCU处理时延/栈水位/冷启动实测。烧录继续等待用户重新要求。

## 持续优化轮次：整段RTL回放与几何修复（未烧录）

本节更新此前“9个ArUco残留漏检”的历史状态。当前17段视频仍未整体通过；数字和形状修改均保留在 `tmp/video_suite_20261029/round2/`，维护RTL尚未替换。没有执行JTAG、下载、复位或电机操作。

### ArUco维护源码与固件审计

保留原严格路径优先，新增按归一化转角简化凸包、强边交点两种四边形救援。救援必须通过图内静区检查：至少三个边的9个采样点中至少7个为亮点；继续要求完整黑边、零码字错误和唯一字典匹配。分割最多6遍（Otsu、低1/2/3级、高1/2级），每遍32个原候选和32个救援候选，复用已有工作区；队列溢出仍终止。

| 离线项目 | 上轮维护源码 | 当前维护源码 |
| --- | ---: | ---: |
| 新标记录像ID23有效帧 / 969 | 811 | 872 |
| OpenCV参考可见178帧的漏检 | 9 | 0 |
| 上轮有效帧丢失 | — | 0 |
| 其余16段ArUco有效输出 | 0 | 0 |
| 旧录像ID23有效帧 / 1657 | 1547 | 1595 |
| 旧录像上轮有效帧丢失 | — | 0 |

旧录像的870个参考可见帧中仍有27帧漏检（843检出），没有将此额外回归写成全部通过。新17段实际11293帧。1255组合成正负例及采集/运行时契约通过；53帧预算分割测试在1、7、64、1024预算下结果一致，最大观测像素读取102004次，另验证饱和队列终止。以上均不能证明MCU实时时延或实际栈水位。

当前固件text30272、data240、bss16572，保留2048字节栈后49132/49152，余20字节。ELF SHA256为 `075a51907cc1199ee64f4919355af99c88dceedeec0619b71367df3da29da71c`。ELF/BIN/MAP保存在 `tmp/maintained_aruco_r2/`；审计 `tmp/video_suite_20261029/round2/aruco_audit.json` 核对源码、旧有效帧保留及产物哈希。

### 数字：隔离原型，仍有漏检和资源缺口

新增Verilator原生C++驱动，执行实际RTL，输入仍为完整1280×720 RGB，只遮挡原Logo。64个12帧窗口之外已反复执行17段连续整段回放，每段只在开头复位；`full_digit_*/result.json` 明确标为诊断而非准确率。数字事件f一般对应源帧f−1，不能直接套同帧标签。

已确认并分别验证：大背景候选吞掉手机数字、相邻衣物并入笔画、旧绿色OSD切断部分黑笔画、暖色白纸超出旧白底色差、前一帧ROI在运动中截断本帧笔画，以及衣领被发布为1。原型分别采用受限候选槽、较窄关联间隔、逐像素中性黑色统计、白纸蓝绿容差、外部静区和类别笔画约束；原有模板ROM未替换。合成七段字体扩展、全局降低占空比、直接冻结照明级等方案均出现退化，未合入。

`digit_strokevote_r2` / `full_digit_strokevote_r2` 记录了本轮一个可复现节点：倾斜3的case24不再发布2；倾斜6的case19已有正确发布；手机0的case35/36/37均有正确发布；整段只展示0的 `23-08-03` 不再输出3；`15-13-00` 整段只输出实际出现的3、4，不再输出5、1；ArUco加四段形状录像均无数字输出。不过第一段数字录像仍漏掉部分6、7、8，其他短窗口也有漏检，不能接受该原型。正在比较保留原归一化的 `recognizer_minimalguards.v`，不能把上述节点写成最终实现。

独立TD综合：原数字模块1322 Slice* / 2 ERAM / 1 DSP；带三槽合并和框跟踪的候选2428 Slice*，不能直接合入原19997 Slice整机。取消组合多槽合并并改两槽后独立1920 Slice*，但case44、54又出现诊断召回下降，亦未接受。独立Slice*不是整机布局结果；20000 Slice、108 ERAM、40 DSP上限未改变。

静态重复帧只用于区分定位/运动与特征失败，不计入真实录像通过率。例如源帧576的清楚8和case19的6，经形态证据原型均可持续正确识别；589的遮挡8、737的遮挡9仍被拒绝。首尾复核、完整12帧复核与每24帧抽样联系图须分开记录，尚未完成全部稳定展示区间的逐帧人工标签。

### 形状：投影支撑原型与协议验证

四段形状录像已完成原生RTL连续回放，参数从维护 `isp_top_user.v` 的实际实例提取。旧彩色OSD的细框会扩大投影极值；单用投影比值放宽不能解决。另确认：一列缺失组会把同色主体分裂，旧小候选占槽后两半不断相互替换，圆会只剩细边。

当前形状原型保持原始面积/包围盒累计，仅对投影极值使用横向连续组和前几行的实体跨度支撑；跨度本身也必须来自横向连续组，不能使用一整行所有离散命中的最外端。另用一个复用平方乘法器比较椭圆在正交方向上的投影能量，按支撑足迹补偿小目标跨度。该方法未增加ERAM，但尚未完成整机资源评估。

`track_solidspan_scheduled.v` 已通过原54组旋转长条/三角/圆/方回归、快速跟踪20帧、默认blob ERAM等价性。串行平方计算提前至跨度就绪后开始，修复了初版发布超出32拍空白期的问题；RGB及边带仍逐拍不变。进一步修复横向历史在行尾/行首、复位之间串联的问题，见 `track_solidspan_reset.v`，该后续版本须重跑同组契约。

`full_shape_solidspan_r2` 中第一段345帧红圆全部正确；第三段红圆378帧、矩形9帧，仍有残留错误，其他录像还存在换纸、撤除和细OSD线被发布为条形的情况，未标为通过。形状事件f对应当前源帧f，与数字事件不同。

### 当前复现入口

```powershell
python tools/audit_round2_aruco_20261029.py
python tools/build_digit_native_round2_20261029.py --name digit_strokevote_r2 --recognizer tmp/video_suite_20261029/round2/recognizer_strokevote.v --locator tmp/video_suite_20261029/round2/locator_aspect.v
python tools/replay_digit_full_round2_20261029.py --model digit_strokevote_r2 --name full_digit_strokevote_r2
python tools/test_native_parity_round2_20261029.py --model digit_strokevote_r2 --video '2026-10-28 12-59-47' --start 282 --frames 12
python tools/test_shape_contract_v107.py --source tmp/video_suite_20261029/round2/track_solidspan_scheduled.v --output tmp/video_suite_20261029/round2/shape_scheduled_contract
python tools/test_native_parity_round2_20261029.py --model shape_solidspan_scheduled_r2 --video '2026-10-28 13-01-11' --start 219 --frames 6
```

上述12帧数字、6帧形状已验证原生与Icarus的全部DTRACE及输出事件一致，证据位于 `round2/parity/`。它们验证回放工具一致性，不替代17段的完整标注、全部功能回归、整机资源和Routed时序闭合。只有ArUco维护C源码已更新，数字/形状候选尚未成为维护RTL，更未部署。

## 继续优化：数字闭环证据、缓存几何和第四方向（未烧录）

本节接续以上历史轮次。数字/形状维护RTL仍未替换；所有新模块和生成器输出保留在隔离目录。17段整段验收、整机20000 Slice/108 ERAM/40 DSP及Routed时序仍未通过，不得把本节单项通过写成整体通过。

### 数字当前保留候选

`digit_union3_r2` 使用 `recognizer_loopwitness.v`、`locator_union3.v` 和原维护640字模板ROM。三槽候选保留完整笔画；仅未确认候选允许两帧有界启动补采，已确认目标撤除的契约不放宽。对1/3/5保留完整笔画质量约束，对6/8/9低距离提议保留拓扑和三次相同特征确认。新增下环弱墨迹证据只有三格比较和六位寄存器，用于区分8/9码本平局，不把实际距离差0伪造为高置信度。

- 17段11293帧连续原生RTL回放完成，证据 `full_digit_union3_r2/result.json`。ArUco及四段形状录像均无数字发布。只含0的23-08-03只输出0；15-13-00仅输出实际展示的3/4；12-59-08原来整段缺失的清晰8在803–810帧已有拓扑确认输出，原始距离差仍为0。
- 冷启动64诊断窗口中，排除原有16个端点标签不适用窗口后44/48有匹配输出，没有标签冲突。残留case3/4/21/26仍需结合遮挡、运动和完整区间标签处理；此计数不是准确率，也不是全视频验收。
- `loopwitness_union3_gallery/result.json`：40个标准正例、8个负例、30个独立±15度字形全部通过。
- `loopwitness_union3_independent_contract/result.json`：发布/保持和精确归一化几何契约通过；82个既有独立场景A/B比较没有新增错误场景或丢失原通过场景。
- `round2/parity/digit_union3_r2_796/result.json`：12-59-08的796起18帧与Icarus全部事件和DTRACE一致，包含新增8提议。
- TD单模块估算2038 Slice*、2 ERAM、1 DSP；尚未满足整机资源合入条件。

亮度扫描增加条件驻留的 `digit_scandwell_r2` 没有放宽识别距离/投票门限。整段部分召回增加，但12-59-08的5展示区间输出消失，因此不接受该方案。固定槽显式选择的 `locator_select3.v` 单模块2065 Slice*，比2038更差，亦未选用。诊断统计不可替代逐区间复核。

### 形状存储与计算重构

新增 `ua_blob_cached_round2` 是栅格顺序专用核心，保留每色两个候选。缓存6份58位几何，投影RAM从每色配对344位改为每候选104位；旧独立blob API及其任意坐标测试保持原样。面积完全相等时保留slot0、替换slot1，以免淘汰当前胜者后依赖未读取的败者投影。此有意的平局规则改变意味着它不能声称与旧核心逐位等价。

`cached_core_contract/result.json` 直接测试新核心，而非仅测试保留的旧模块：三方向与四方向各128帧，分别覆盖157862次连续同址读写冲突、1721次等面积替换、10309次候选重建、42269次气泡；包括空帧、SOF/EOF命中、同色双目标、频繁切色及描述符在途复位。独立计分板核对包围盒、面积、各投影跨度和最大目标选择，两组均通过。支持滤波开启路径还由旋转回归和原生/Icarus视频对照核验。

| 隔离形状模块 | Slice*估算 | ERAM | DSP | 验证边界 |
| --- | ---: | ---: | ---: | --- |
| 原维护基线 | 2651 | 9 | 8 | 仅供同包装单模块比较 |
| solidspan + 去额外平方不变量 | 3230 | 9 | 8 | 既有54旋转/20快速跟踪通过 |
| cached三方向 | 2707 | 3 | 8 | 54旋转/20快速跟踪/直接核心通过 |
| cached四方向 | 3158 | 4 | 8 | 同上；仍有真实视频误分类 |
| 四方向帧末分时计算 | 2835 | 4 | 6 | 与四方向四段整段输出逐项相同；回归通过 |

第四方向增加 `(2x+5y,-5x+2y)` 的正交跨度，使长条长宽比可从缺方向补偿3:2恢复到2:1；仍保留细长条功能。没有修改回放中的旧彩色OSD，也没有删除薄条负担来制造通过。

四方向方案在23-09-03中红色长条输出20→5帧，但出现8帧方形输出，因此仍不能接受。逐帧原图确认49附近的红圆纸面反光，算法只拾取下半部；203/205–207/209附近三角形也有反光/运动干扰。13-01-22的380–406还包含换纸和强透视变形。截图 `round2/shape_failure_review.jpg`；完整事件区间 `round2/shape_probe_audit.json`。不能因为少数窗口改善就宣告四段通过。

帧末分时版本共用一个面积乘法器，在12个EOF时隙依次计算三色四方向，分类时隙5/9/13、原子发布时隙14；RGB流不变。现有32拍空白快速跟踪测试通过。四段1645帧的全部DTRACE和输出事件与未分时四方向版本一致，审计工具 `tools/audit_shape_probes_round2_20261029.py` 进行逐项断言。三方向缓存6帧、四方向12帧已通过原生/Icarus一致性；分时版本对照另行记录。

反光ROI实验 `track_glare_roi.v` 仅在上一帧有效红色目标原始框内允许原有1/3饱和度分支，保留亮度、chroma、色相及主色领先要求，不能用该分支启动新目标。虽通过54旋转/20快速跟踪，但四段完整视频中11-00-07新增方形输出，故拒绝。改用平滑发布框的 `track_glare_smooth.v` 同样在11-00-07新增方形，也未接受。`track_glare_trace.v` 仅用于输出帧末面积和投影诊断，不能用于综合或当作新验收候选。

数字候选额外的10场景高光/暗卡测试和切换亮度数字8测试全部通过，见 `loopwitness_union3_glare/result.json`。分时形状8帧原生/Icarus对照亦通过，见 `parity/shape_serialaxis_r2_190/result.json`。资源分解估算：新识别器搭配旧定位器1610 Slice*，旧识别器搭配三槽定位器1830 Slice*；这是定位开销的拆分诊断，不能把其中混合组合当作已验证可用实现。

以上全部为离线仿真或单模块TD综合。尚无新整机布局、最终时序、硬件帧率、栈水位或板上检测结论。烧录继续暂停。
