Wooohaaa/anlogic-vision-system/verification/r6_source_snapshot/mcu_tracking/stepper_firmware/main.c

#define CAMERA_ARUCO_BUILD 1
#define CAMERA_STEPPER_BUILD 1
#include "../aruco_app/aruco_log.c"
#include "../stepper_app/stepper_control.c"
#include "../stepper_app/main.c"
#include "../aruco_app/aruco_decode.c"
#include "../aruco_app/aruco_refine.c"
#include "../aruco_app/aruco_detect.c"
#include "../aruco_app/aruco_capture.c"
#include "../aruco_app/aruco_pose.c"
#include "../aruco_app/aruco_runtime.c"
