Wooohaaa/anlogic-vision-system/verification/r6_source_snapshot/mcu_tracking/aruco_app/aruco_dictionary.h

#ifndef UA_ARUCO_DICTIONARY_H
#define UA_ARUCO_DICTIONARY_H
#include <stdint.h>
/* OpenCV 4.10 DICT_4X4_50, row-major bit0=top-left, white=1.
 * Generated using Dictionary_getBitsFromByteList, not bytesList byte order. */
static const uint16_t ua_aruco_codes[50] = {
  0x4cadu, /* 0 */
  0x59f0u, /* 1 */
  0xb4ccu, /* 2 */
  0x6299u, /* 3 */
  0x792au, /* 4 */
  0xb39eu, /* 5 */
  0x7479u, /* 6 */
  0x4f23u, /* 7 */
  0x5b7fu, /* 8 */
  0x6af3u, /* 9 */
  0x899fu, /* 10 */
  0xe588u, /* 11 */
  0xed70u, /* 12 */
  0xf054u, /* 13 */
  0x8d24u, /* 14 */
  0x7c64u, /* 15 */
  0xa662u, /* 16 */
  0x0066u, /* 17 */
  0x7a36u, /* 18 */
  0xf56eu, /* 19 */
  0xd161u, /* 20 */
  0xd40du, /* 21 */
  0xab33u, /* 22 */
  0x41bbu, /* 23 */
  0xe27fu, /* 24 */
  0x8e29u, /* 25 */
  0x2735u, /* 26 */
  0x2aa5u, /* 27 */
  0xc484u, /* 28 */
  0xf62cu, /* 29 */
  0xa822u, /* 30 */
  0x4deau, /* 31 */
  0xf379u, /* 32 */
  0xd30fu, /* 33 */
  0x7510u, /* 34 */
  0x9490u, /* 35 */
  0xae18u, /* 36 */
  0xff20u, /* 37 */
  0x6fb0u, /* 38 */
  0x5a38u, /* 39 */
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
};
#endif
