Wooohaaa/anlogic-vision-system/(commit log)

2026-10-24 Initial v94 FPGA and MCU delivery
    [.m_params_MCU.txt, .m_params_PLL.txt, .m_params_blk_mem_gen_awb_delay_signal.txt, .m_params_blk_mem_gen_demosaic.txt, .m_params_blk_mem_gen_zhenghe.txt, .m_params_ddr2.txt, .m_params_w128_d512_fifo.txt, .m_params_w155_d512_fifo.txt]
2026-11-01 Refresh technical document with latest board screenshots
2026-11-01 Describe competition validation using board demonstrations
2026-11-01 Replace assembled-system photos in competition document
